HassRadhi/Multimeter/hardware/V15_USB_isolator.brd

## EAGLE design hardware/V15_USB_isolator.brd (2026-11-10)

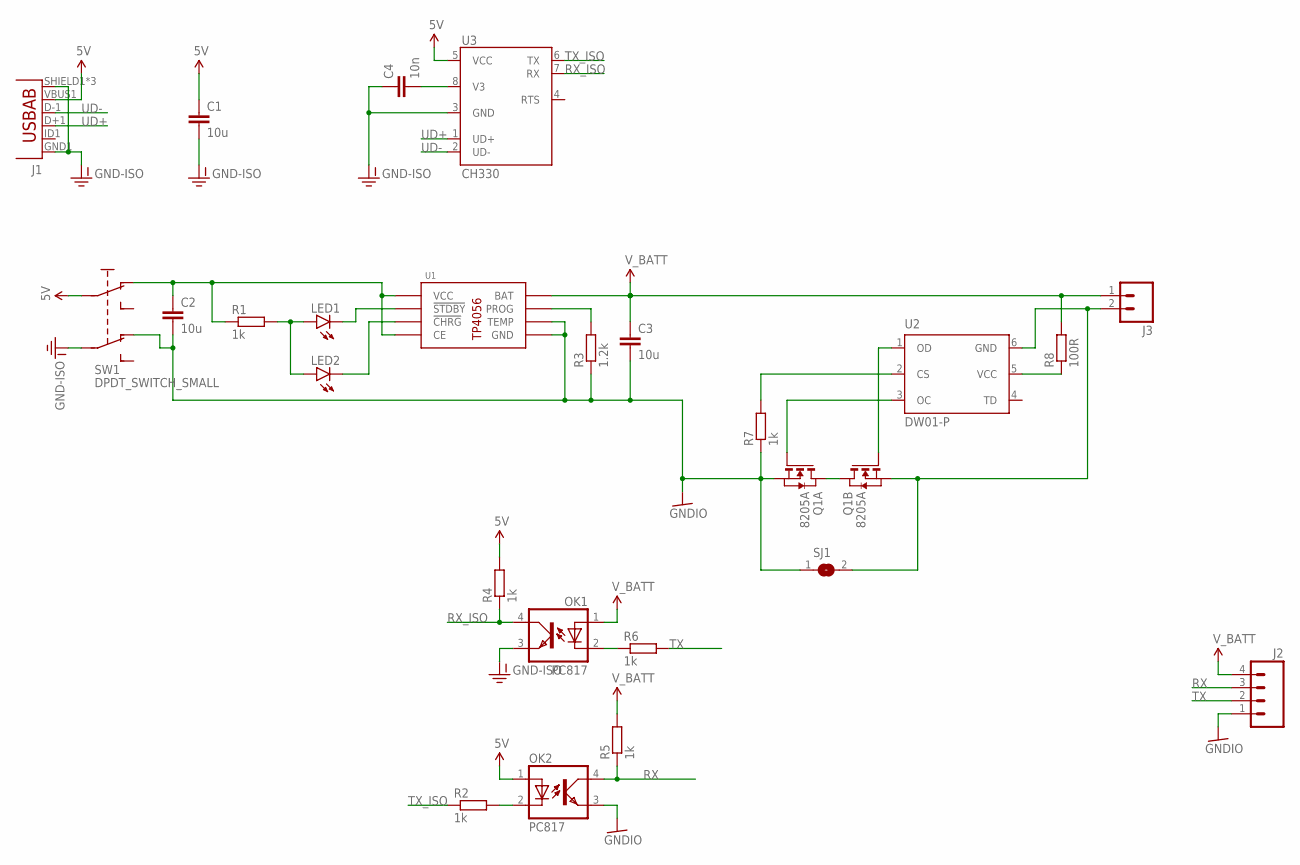
[picture p3: schematic V15_USB_isolator.sch]

Parts:
C1, C2, C3: 10u; C1206
C4: 10n; C1206
J1: USB-ABCONN-11794; USB-AB-MICRO-SMD_V03
J2: M04PTH; 1X04@1
J3: M02PTH3; 1X02_LONGPADS
LED1, LED2: LED1206-BOTTOM; LED-1206-BOTTOM
OK1, OK2: PC817; DIL04
Q1: 8205A; TSSOP8
R1, R2, R4, R5, R6, R7: 1k; R1206
R3: 1.2k; R1206
R8: 100R; R1206
SJ1: SJ
SW1: DPDT_SWITCH_SMALL; DPDT_SMALL
U1: TP4056; SOP8
U2: DW01-P; SOT23-6L
U3: CH330; SO08

Connections:
5V: C1.1, J1.VBUS1 (VBUS), OK2.1 (A), R4.2, SW1.P$2 (I1), U3.5 (VCC)
5V_ISO: C2.1, R1.1, SW1.P$1 (NC1), U1.4 (VCC), U1.8 (CE)
GND-ISO: C1.2, C4.1, J1.GND1 (GND), J1.SHIELD1 (SHIELD), J1.SHIELD2 (SHIELD), J1.SHIELD3 (SHIELD), OK1.3 (EMIT), SW1.P$5 (I2), U3.3 (GND)
GNDIO: C2.2, C3.2, J2.1, OK2.3 (EMIT), Q1.2 (S), Q1.3 (S), R3.1, R7.1, SJ1.1, SW1.P$6 (NC2), U1.1 (TEMP), U1.3 (GND)
unnamed: C4.2, U3.8 (V3)
unnamed: Q1.1 (D), Q1.8 (D)
unnamed: LED1.A, LED2.A, R1.2
unnamed: LED1.C, U1.6 (!STDBY)
unnamed: LED2.C, U1.7 (!CHRG)
unnamed: R3.2, U1.2 (PROG)
unnamed: OK2.2 (C), R2.2
unnamed: OK1.2 (C), R6.1
unnamed: R8.1, U2.5 (VCC)
unnamed: J3.2, Q1.6 (S), Q1.7 (S), SJ1.2, U2.6 (GND)
unnamed: Q1.5 (G), U2.1 (OD)
unnamed: Q1.4 (G), U2.3 (OC)
unnamed: R7.2, U2.2 (CS)
RX: J2.3, OK2.4 (COL), R5.1
RX_ISO: OK1.4 (COL), R4.1, U3.7 (RX)
TX: J2.2, R6.2
TX_ISO: R2.1, U3.6 (TX)
UD+: J1.D+1 (D+), U3.1 (UD+)
UD-: J1.D-1 (D-), U3.2 (UD-)
V_BATT: C3.1, J2.4, J3.1, OK1.1 (A), R5.2, R8.2, U1.5 (BAT)

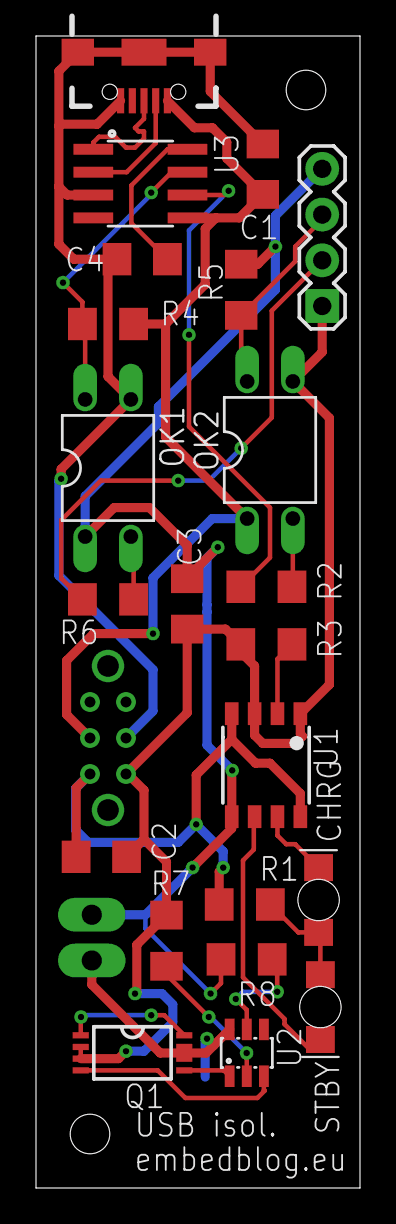
[picture p4: board V15_USB_isolator.brd from above]

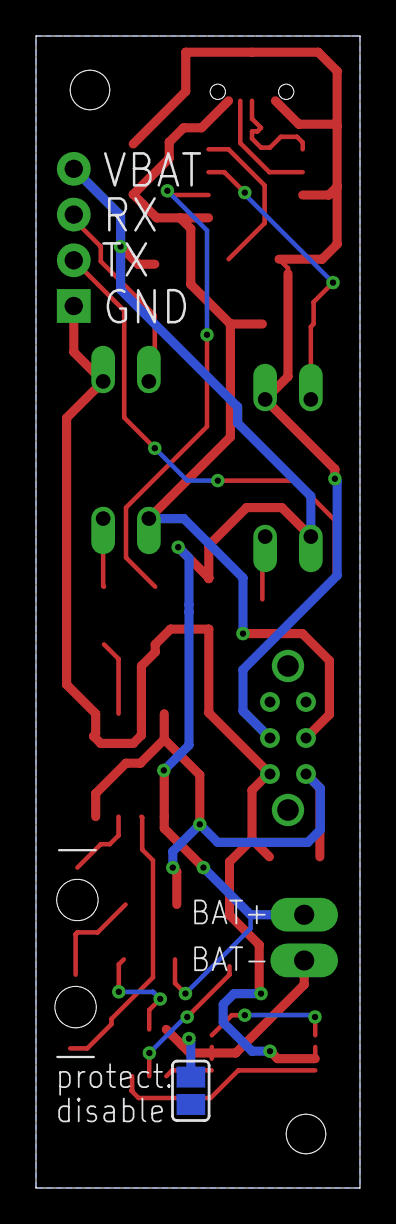
[picture p5: board V15_USB_isolator.brd from below]

Board: 2 copper layers, 18.0 x 64.0 mm, 25 parts (2 on the bottom side), 24 nets.
