HassRadhi/Multimeter/hardware/v15.brd

## EAGLE design hardware/v15.brd (2026-11-10)

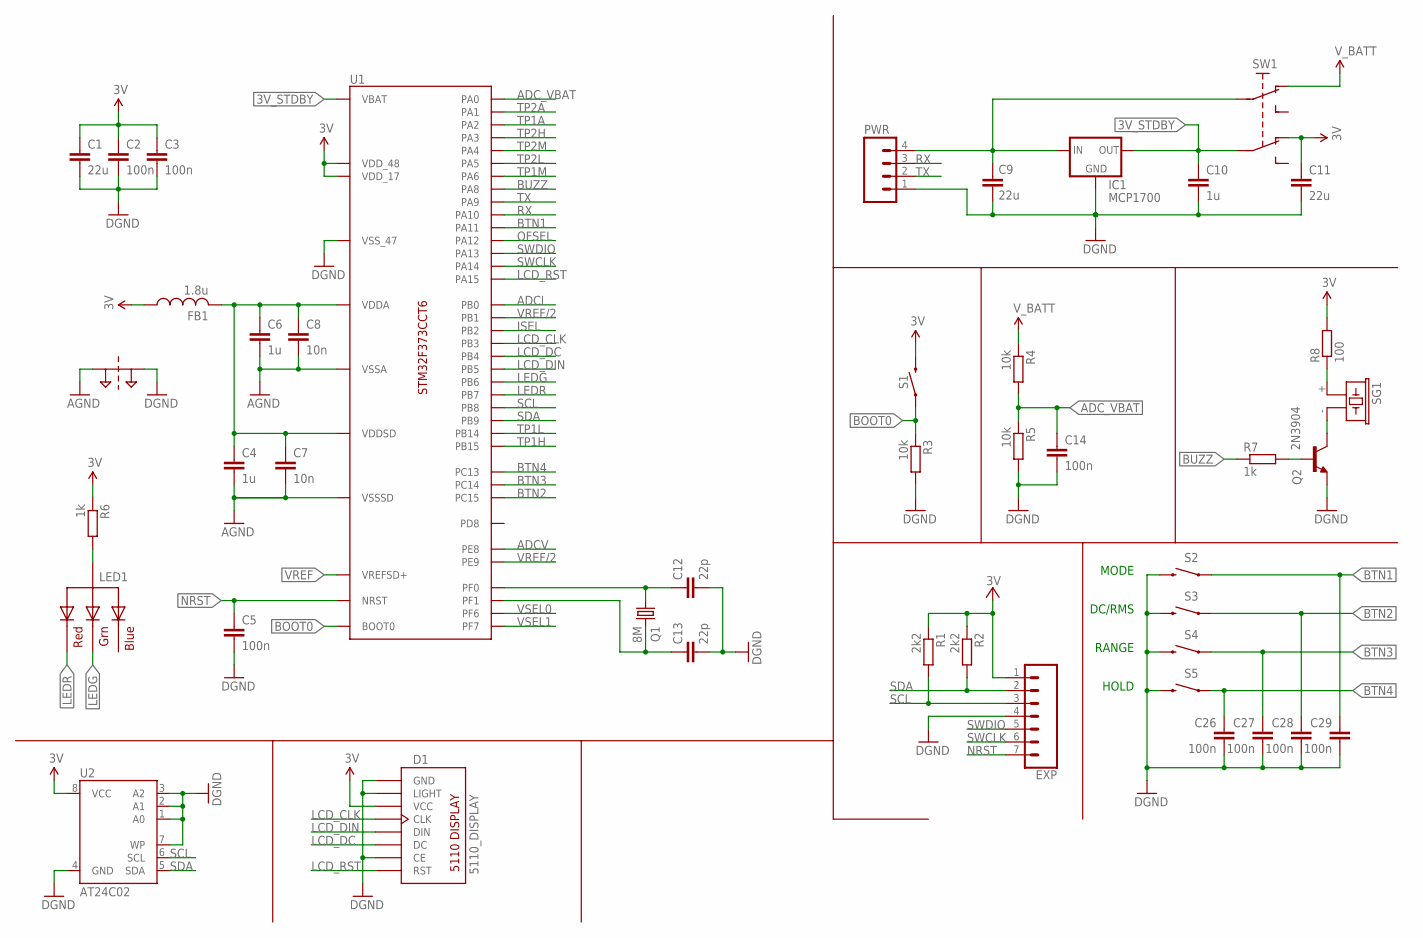
[picture p6: schematic v15.sch, sheet 1, Microcontroller & IO]

Parts:
C1, C9, C11: 22u; C1206
C2, C3, C5, C14, C26, C27, C28, C29: 100n; C1206
C4, C6, C10: 1u; C1206
C7, C8: 10n; C1206
C12, C13: 22p; C1206
D1: 5110_DISPLAY; 5110_LAYOUT
EXP: CONN_07; 1X07
FB1: 1.8u; 1206
IC1: MCP1700; SOT23
LED1: RGBLED_CA-5MM; LED5MMRGB
PT1: 2PT_GND_TIE
PWR: M04PTH; 1X04@1
Q1: 8M; HC49U-V
Q2: 2N3904; SOT23
R1, R2: 2k2; R1206
R3, R4, R5: 10k; R1206
R6, R7: 1k; R1206
R8: 100; R1206
S1: MOMENTARY-SWITCH-SPST-PTH-6.0MM; TACTILE_SWITCH_PTH_6.0MM
S2, S3, S4, S5: MOMENTARY-SWITCH-SPST-SMD-12MM; TACTILE_SWITCH_SMD_12MM
SG1: F/CM12P
SW1: DPDT_SWITCH_SMALL; DPDT_SMALL
U1: STM32F373CCT6; LQFP-48
U2: AT24C02; SOIC8

Connections:
3V: C1.1, C2.1, C3.1, C11.1, D1.VCC, EXP.1, FB1.1, R1.1, R2.1, R6.1, R8.2, S1.3 (2), SW1.P$6 (NC2), U1.17 (VDD_17), U1.48 (VDD_48), U2.8 (VCC); also elsewhere on the board
3V_STDBY: C10.1, IC1.2 (OUT), SW1.P$5 (I2), U1.1 (VBAT)
ADCI: U1.18 (PB0); also elsewhere on the board
ADCV: U1.21 (PE8); also elsewhere on the board
ADC_VBAT: C14.1, R4.2, R5.1, U1.10 (PA0)
AGND: C4.2, C6.2, C7.2, C8.2, PT1.P$1, U1.8 (VSSA), U1.23 (VSSSD); also elsewhere on the board
BOOT0: R3.1, S1.1, U1.44 (BOOT0)
BTN1: C29.1, S2.1, U1.32 (PA11)
BTN2: C28.1, S3.1, U1.4 (PC15)
BTN3: C27.1, S4.1, U1.3 (PC14)
BTN4: C26.1, S5.1, U1.2 (PC13)
BUZZ: R7.1, U1.29 (PA8)
GND: C1.2, C2.2, C3.2, C5.2, C9.2, C10.2, C11.2, C12.2, C13.2, C14.2, C26.2, C27.2, C28.2, C29.2, D1.CE, D1.GND, D1.LIGHT, EXP.4, IC1.1 (GND), PT1.P$2, PWR.1, Q2.2 (E), R3.2, R5.2, S2.3 (2), S3.3 (2), S4.3 (2), S5.3 (2), U1.47 (VSS_47), U2.1 (A0), U2.2 (A1), U2.3 (A2), U2.4 (GND), U2.7 (WP)
ISEL: U1.20 (PB2); also elsewhere on the board
LCD_CLK: D1.CLK, U1.39 (PB3)
LCD_DC: D1.DC, U1.40 (PB4)
LCD_DIN: D1.DIN, U1.41 (PB5)
LCD_RST: D1.RST, U1.38 (PA15)
LEDG: LED1.3 (GREEN), U1.42 (PB6)
LEDR: LED1.1 (RED), U1.43 (PB7)
unnamed: C12.1, Q1.1, U1.5 (PF0)
unnamed: C4.1, C6.1, C7.1, C8.1, FB1.2, U1.9 (VDDA), U1.24 (VDDSD)
unnamed: C9.1, IC1.3 (IN), PWR.4, SW1.P$2 (I1)
unnamed: LED1.2 (VCC), R6.2
unnamed: R8.1, SG1.+ (1)
unnamed: C13.1, Q1.2, U1.6 (PF1)
unnamed: Q2.3 (C), SG1.- (2)
unnamed: Q2.1 (B), R7.2
NRST: C5.1, EXP.7, U1.7 (NRST)
OFSEL: U1.33 (PA12); also elsewhere on the board
RX: PWR.3, U1.31 (PA10)
SCL: EXP.3, R1.2, U1.45 (PB8), U2.6 (SCL)
SDA: EXP.2, R2.2, U1.46 (PB9), U2.5 (SDA)
SWCLK: EXP.6, U1.37 (PA14)
SWDIO: EXP.5, U1.34 (PA13)
TP1A: U1.12 (PA2); also elsewhere on the board
TP1H: U1.27 (PB15); also elsewhere on the board
TP1L: U1.26 (PB14); also elsewhere on the board
TP1M: U1.16 (PA6); also elsewhere on the board
TP2A: U1.11 (PA1); also elsewhere on the board
TP2H: U1.13 (PA3); also elsewhere on the board
TP2L: U1.15 (PA5); also elsewhere on the board
TP2M: U1.14 (PA4); also elsewhere on the board
TX: PWR.2, U1.30 (PA9)
VREF: U1.25 (VREFSD+); also elsewhere on the board
VREF/2: U1.19 (PB1), U1.22 (PE9); also elsewhere on the board
VSEL0: U1.35 (PF6); also elsewhere on the board
VSEL1: U1.36 (PF7); also elsewhere on the board
V_BATT: R4.1, SW1.P$1 (NC1)

Notes on the sheet:
MODE
RANGE
DC/RMS
HOLD

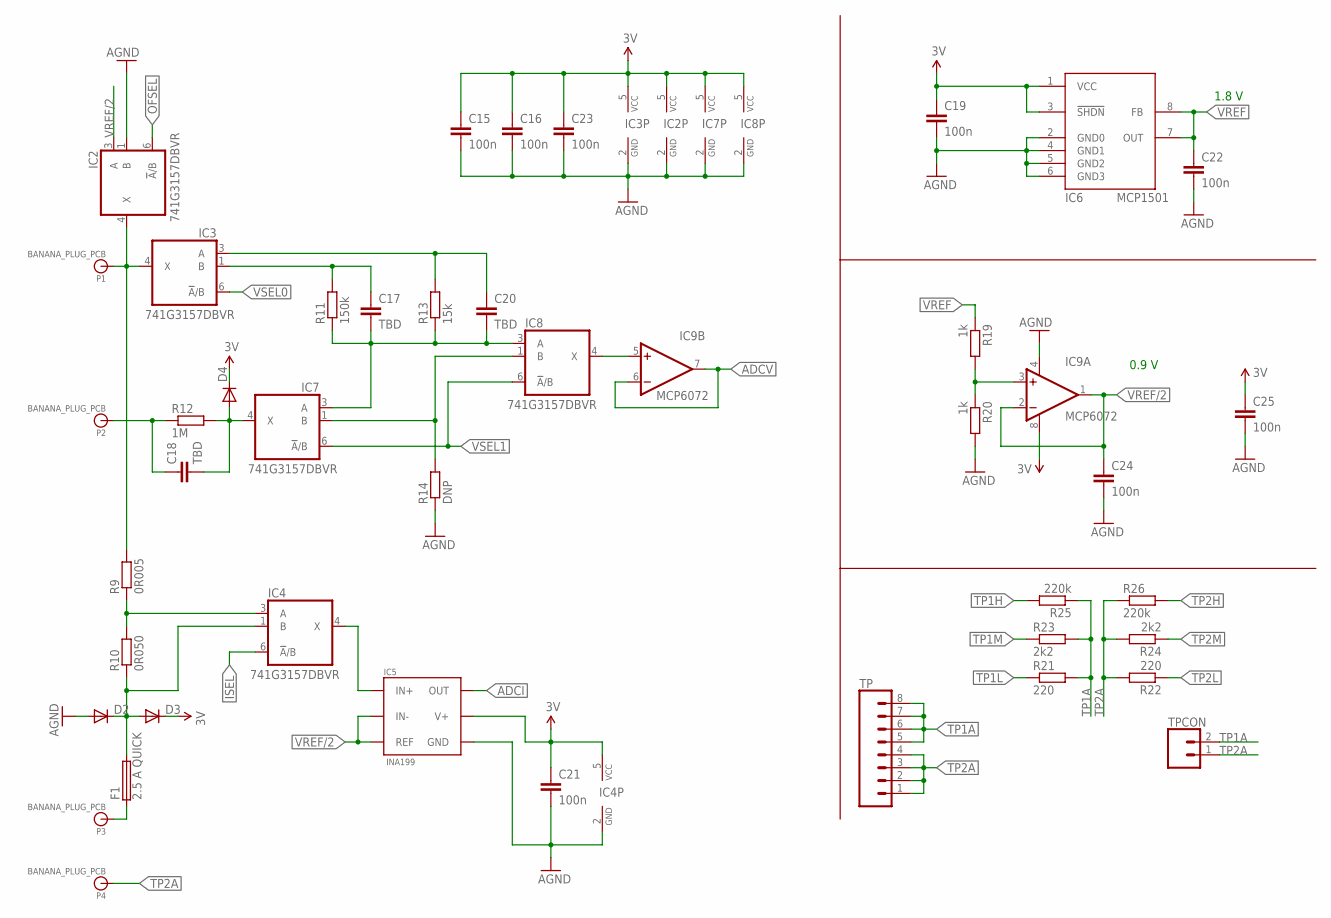
[picture p7: schematic v15.sch, sheet 2, Analog Front End]

Parts:
C15, C16, C21, C23: 100n; 1206
C17, C18, C20: TBD; 1206
C19, C22, C24, C25: 100n; C1206
D2, D3, D4: DIODE-MINIMELF; MINIMELF
F1: 2.5 A QUICK; SHK20L
IC2, IC3, IC4, IC7, IC8: 741G3157DBVR; DBV_R-PDSO-G6
IC5: INA199; SC70-6
IC6: MCP1501; SO08
IC9: MCP6072; SO08
P1, P2, P3, P4: BANANA_PLUG_PCB; BANANA_6MMHOLE
R9: 0R005; R1206
R10: 0R050; R1206
R11: 150k; R1206
R12: 1M; R1206
R13: 15k; R1206
R14: DNP; R1206
R19, R20: 1k; R1206
R21, R22: 220; R1206
R23, R24: 2k2; R1206
R25, R26: 220k; R1206
TP: CONN_08SMD-STRAIGHT-FEMALE; 1X08_SMD
TPCON: CONN_02; 1X02

Connections:
3V: C15.1, C16.1, C19.1, C21.1, C23.1, C25.1, D3.C, D4.C, IC2.5 (VCC), IC3.5 (VCC), IC4.5 (VCC), IC5.3 (V+), IC6.1 (VCC), IC6.3 (!SHDN), IC7.5 (VCC), IC8.5 (VCC), IC9.8 (V+); also elsewhere on the board
ADCI: IC5.6 (OUT); also elsewhere on the board
ADCV: IC9.6 (-IN), IC9.7 (OUT); also elsewhere on the board
AGND: C15.2, C16.2, C19.2, C21.2, C22.2, C23.2, C24.2, C25.2, D2.A, IC2.1 (B), IC2.2 (GND), IC3.2 (GND), IC4.2 (GND), IC5.2 (GND), IC6.2 (GND0), IC6.4 (GND1), IC6.5 (GND2), IC6.6 (GND3), IC7.2 (GND), IC8.2 (GND), IC9.4 (V-), R14.1, R20.2; also elsewhere on the board
COM: IC2.4 (X), IC3.4 (X), P1.P$1, R9.2
ISEL: IC4.6 (!A!/B); also elsewhere on the board
unnamed: C18.1, P2.P$1, R12.1
unnamed: C17.1, IC3.1 (B), R11.2
unnamed: C20.1, IC3.3 (A), R13.2
unnamed: C18.2, D4.A, IC7.4 (X), R12.2
unnamed: IC4.3 (A), R9.1, R10.2
unnamed: C17.2, C20.2, IC7.3 (A), IC8.3 (A), R11.1, R13.1
unnamed: D2.C, D3.A, F1.2A (2), IC4.1 (B), R10.1
unnamed: IC8.4 (X), IC9.5 (+IN)
unnamed: IC7.1 (B), IC8.1 (B), R14.2
unnamed: IC9.3 (+IN), R19.2, R20.1
unnamed: IC4.4 (X), IC5.4 (IN+)
unnamed: F1.1A (1), P3.P$1
OFSEL: IC2.6 (!A!/B); also elsewhere on the board
TP1A: R21.2, R23.2, R25.1, TP.5, TP.6, TP.7, TP.8, TPCON.2; also elsewhere on the board
TP1H: R25.2; also elsewhere on the board
TP1L: R21.1; also elsewhere on the board
TP1M: R23.1; also elsewhere on the board
TP2A: P4.P$1, R22.2, R24.2, R26.1, TP.1, TP.2, TP.3, TP.4, TPCON.1; also elsewhere on the board
TP2H: R26.2; also elsewhere on the board
TP2L: R22.1; also elsewhere on the board
TP2M: R24.1; also elsewhere on the board
VREF: C22.1, IC6.7 (OUT), IC6.8 (FB), R19.1; also elsewhere on the board
VREF/2: C24.1, IC2.3 (A), IC5.1 (REF), IC5.5 (IN-), IC9.1 (OUT), IC9.2 (-IN); also elsewhere on the board
VSEL0: IC3.6 (!A!/B); also elsewhere on the board
VSEL1: IC7.6 (!A!/B), IC8.6 (!A!/B); also elsewhere on the board

Notes on the sheet:
1.8 V
0.9 V

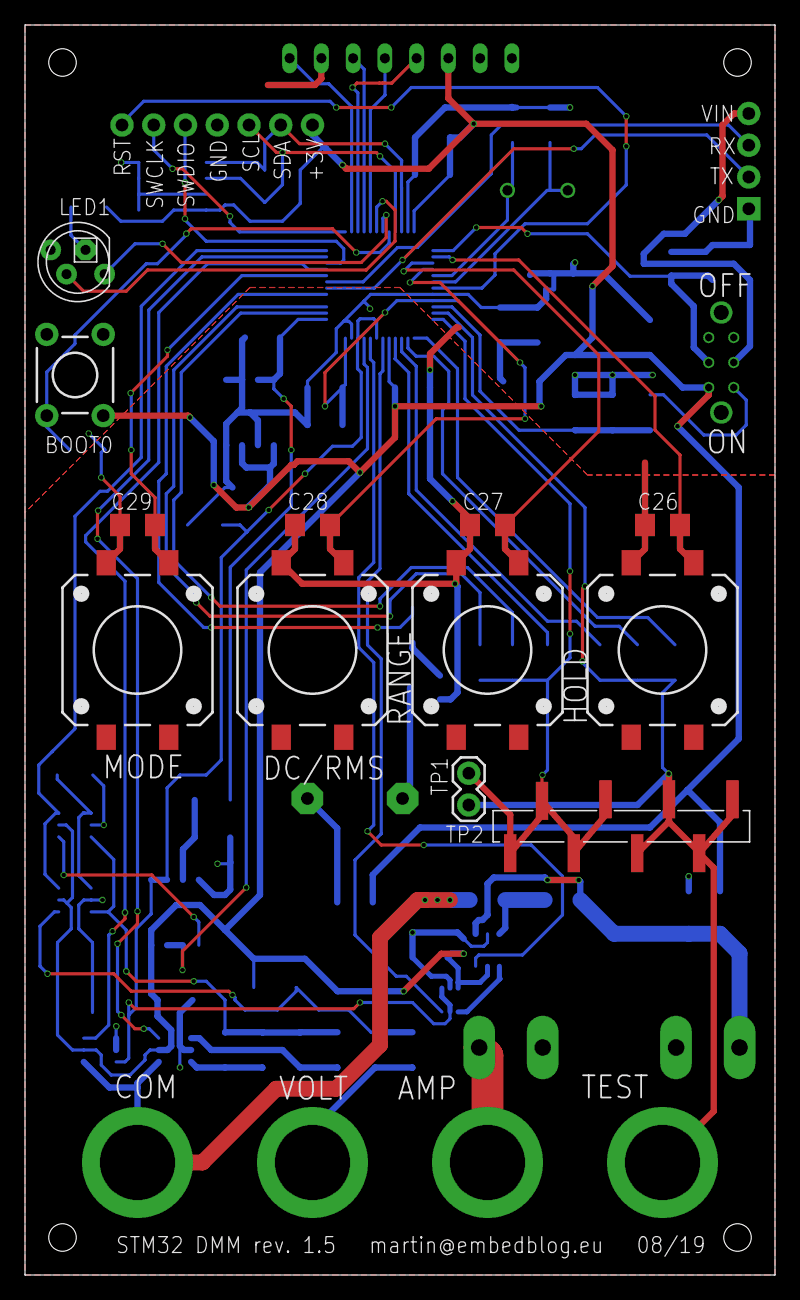
[picture p8: board v15.brd from above]

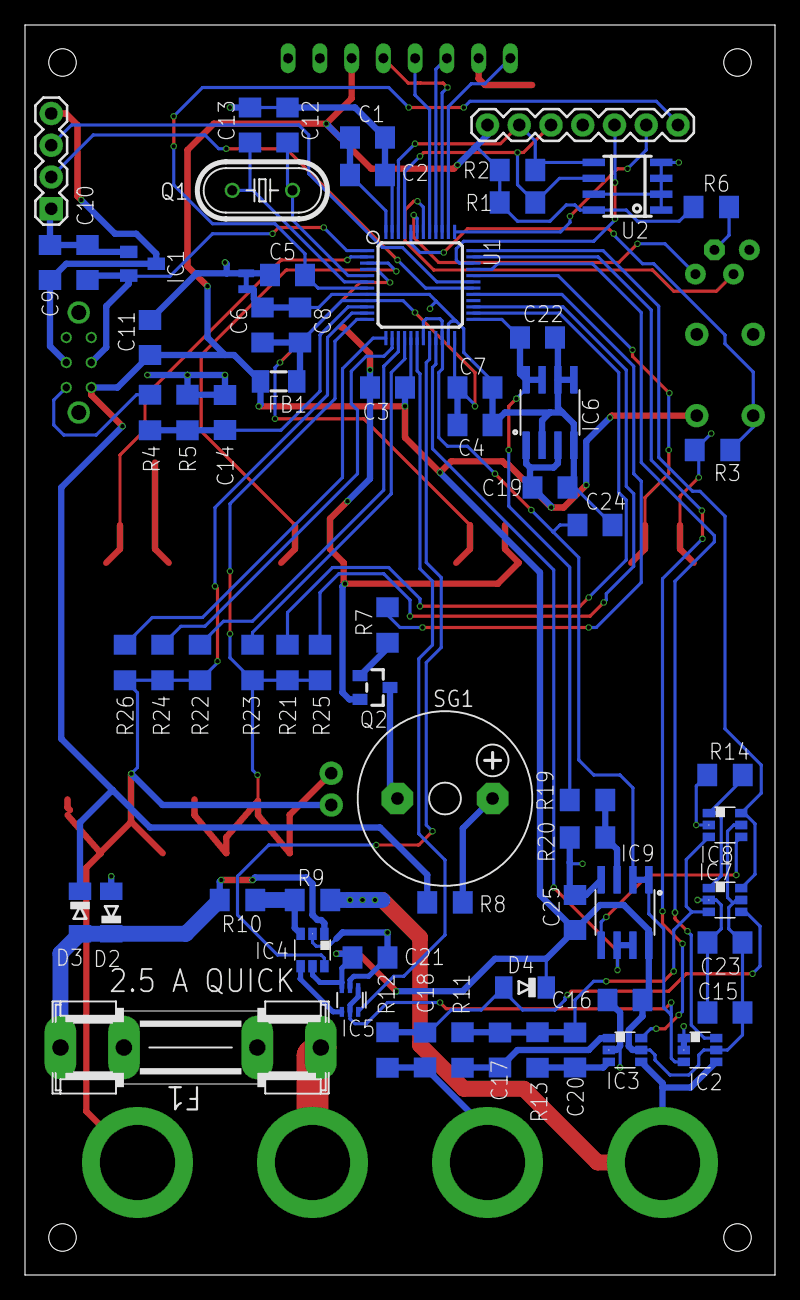
[picture p9: board v15.brd from below]

Board: 2 copper layers, 60.0 x 100.0 mm, 87 parts (69 on the bottom side), 62 nets.
