HassRadhi/Multimeter/(commit log)

2026-11-10 Add MartinD OSM v1.5 hardware and KiCad import
    Include original Eagle schematic/PCB/library files, USB isolator,
    schematic preview PNGs, BOM, DigiKey notes, and the KiCad-imported
    v15 project for continued work.
    [V15_USB_isolator.brd, V15_USB_isolator.sch, v15.brd, v15.kicad_sch, v15.sch, v15_2.kicad_sch]
2026-11-10 Add imported KiCad PCB layout
    Restore v15.kicad_pcb from local KiCad history so the board is in the repo.
    [v15.kicad_pcb]
2026-11-10 Add agent handoff prompt for desktop continuation
    Summarises project goals, OLED swap, schematic map, and next steps
    for a new Cursor agent session.
2026-11-10 Replace Nokia 5110 with SSD1306 7-pin OLED header
    Swap D1 to Conn_01x07 with common module pin order (DGND, 3V, CLK, DIN, RST, DC, CS-to-DGND) and PinHeader_1x07 footprint so firmware can drive an SSD1306 over the existing LCD_* nets.
    [v15.kicad_pcb, v15.kicad_sch]
2026-11-11 Add fresh Eagle KiCad import with SSD1306 OLED header
    Import MartinD v15 into hardware/v15_1 with copper intact, replace the Nokia 5110 with a 7-pin SPI OLED connector on schematic and PCB, and route only the display nets.
    [v15.kicad_pcb, v15.kicad_sch, v15_2.kicad_sch]
2026-11-13 Add v15_1 fab Gerbers and PCB layout polish
    Store JLCPCB-ready Gerber/drill outputs and updated board after OLED routing and DRC exclusions for prototype order.
    [v15-B_Adhesive.gbr, v15-B_Cu.gbr, v15-B_Mask.gbr, v15-B_Paste.gbr, v15-B_Silkscreen.gbr, v15-Edge_Cuts.gbr, v15-F_Cu.gbr, v15-F_Mask.gbr]
2026-11-13 feat(firmware): add CubeMX F373 skeleton and firmware docs
    Scaffold VS Code/CMake project for STM32F373CCT6 and document style, phased firmware plan, and toolchain setup.
    [v15.kicad_pcb]
